ScottYates/ceilingclock/hardware/stl/lens_cap.stl

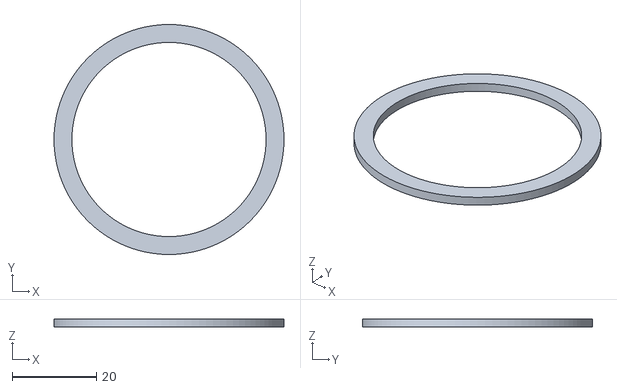
[picture p1: CAD file, 2026-10-31]
hardware/stl/lens_cap.stl
54.5 x 54.5 x 2.00
