ScottYates/ceilingclock/hardware/stl/lens_mount.stl

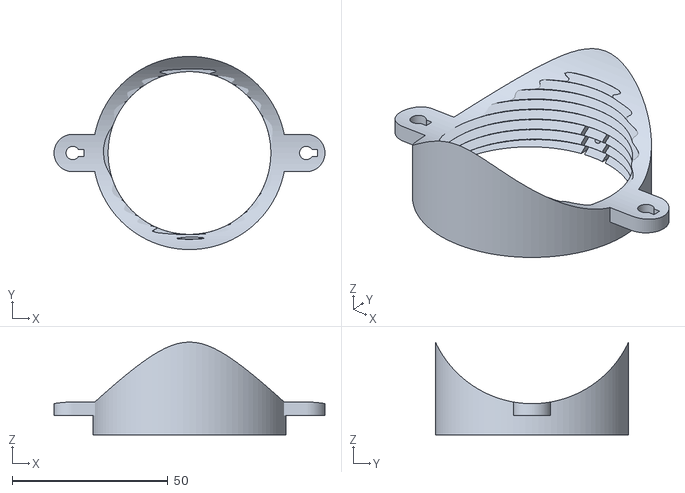
[picture p2: CAD file, 2026-10-31]
hardware/stl/lens_mount.stl
87.0 x 62.0 x 29.8
