ScottYates/ceilingclock/hardware/stl/base_056.stl

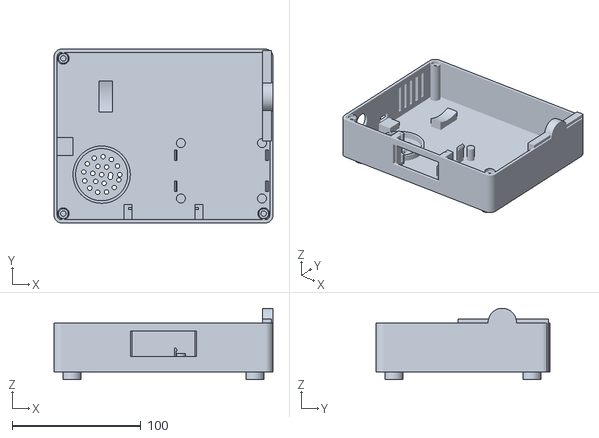
[picture p3: CAD file, 2026-10-31]
hardware/stl/base_056.stl
170.0 x 135.0 x 55.5
