ScottYates/ceilingclock/hardware/stl/lid.stl

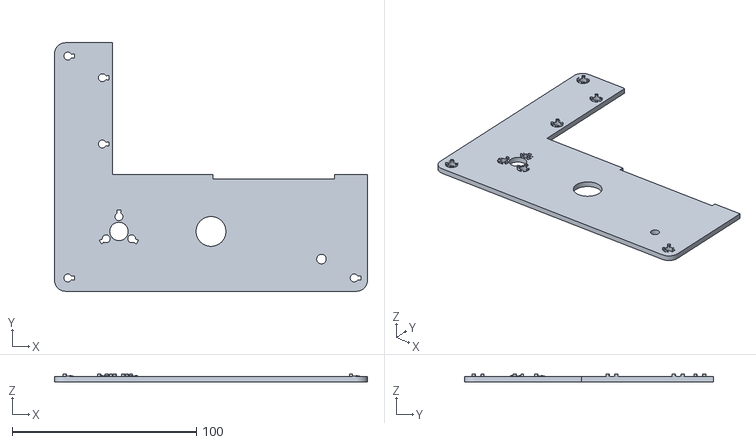
[picture p4: CAD file, 2026-10-31]
hardware/stl/lid.stl
170.0 x 135.0 x 4.20
