ScottYates/ceilingclock/hardware/stl/dome.stl

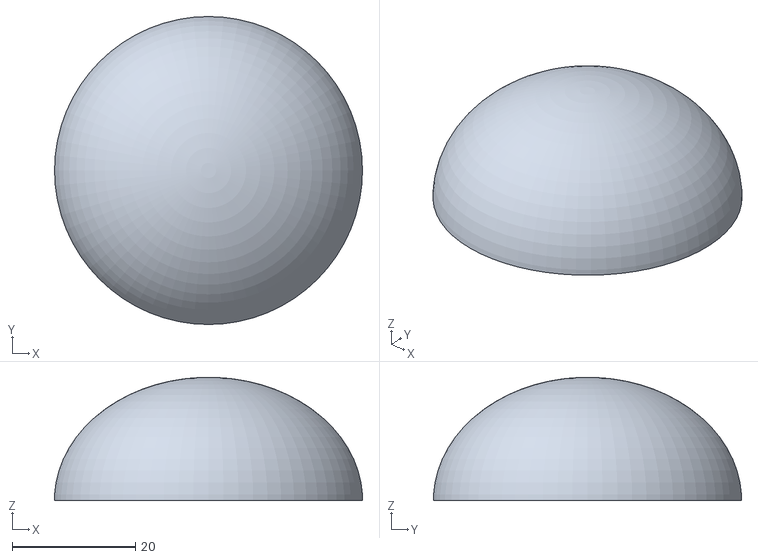
[picture p5: CAD file, 2026-10-31]
hardware/stl/dome.stl
49.9 x 49.9 x 20.0
