ScottYates/ceilingclock/hardware/stl/led_cap.stl

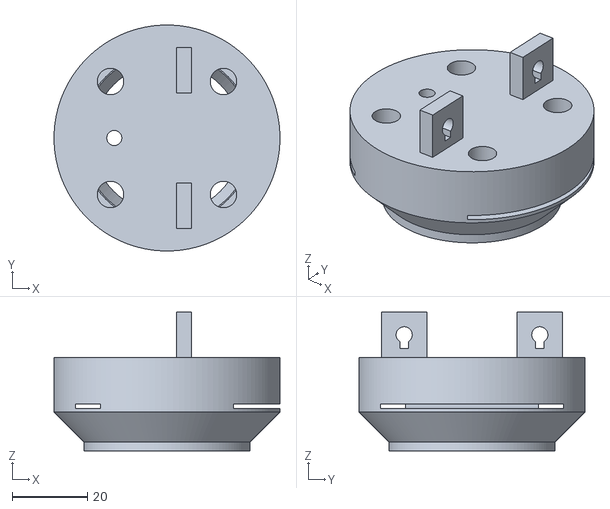
[picture p6: CAD file, 2026-10-31]
hardware/stl/led_cap.stl
60.0 x 60.0 x 36.8
