ScottYates/ceilingclock/hardware/stl/lcd_holder.stl

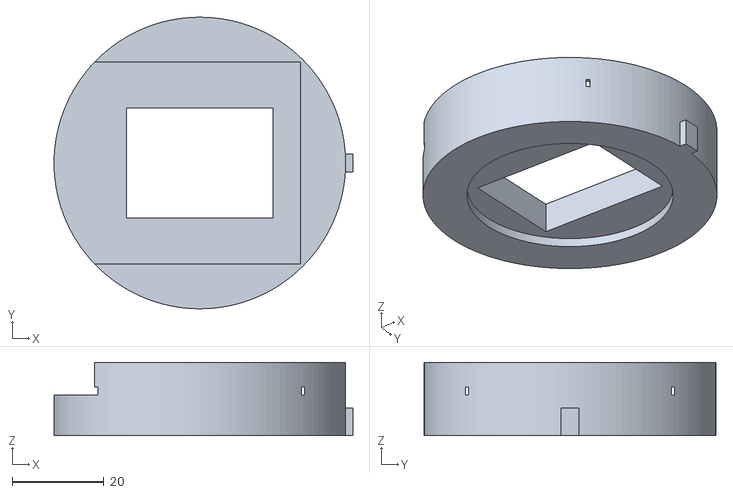
[picture p7: CAD file, 2026-10-31]
hardware/stl/lcd_holder.stl
65.2 x 63.6 x 16.0
