ScottYates/ceilingclock/hardware/stl/sleeve.stl

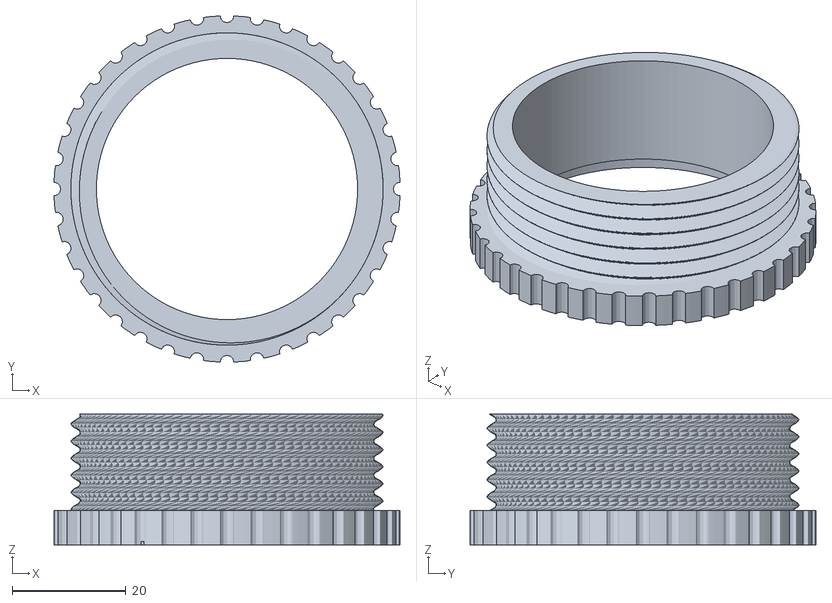
[picture p8: CAD file, 2026-10-31]
hardware/stl/sleeve.stl
60.9 x 60.9 x 23.0
