ScottYates/ceilingclock/hardware/stl/ring_holder.stl

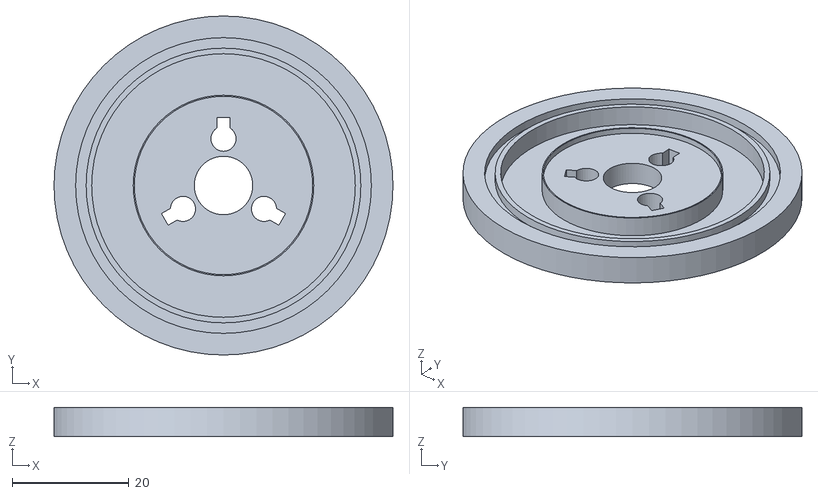
[picture p9: CAD file, 2026-10-31]
hardware/stl/ring_holder.stl
58.0 x 58.0 x 5.00
