ScottYates/ceilingclock/hardware/stl/barrel.stl

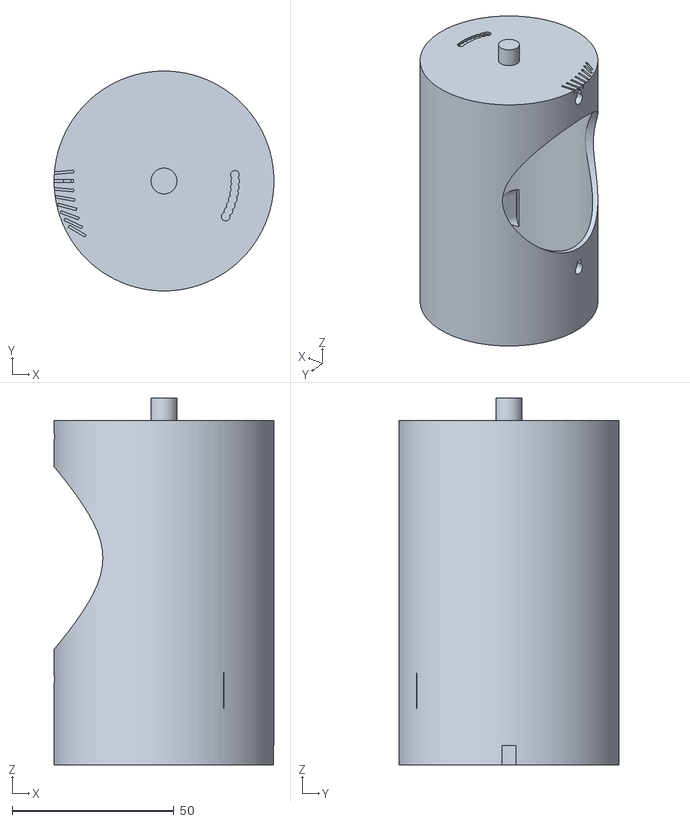
[picture p10: CAD file, 2026-10-31]
hardware/stl/barrel.stl
68.0 x 68.0 x 113.5
