ScottYates/ceilingclock/hardware/stl/pins.stl

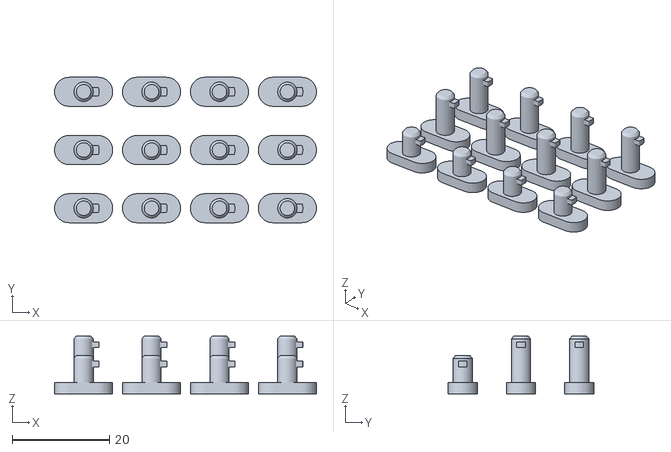
[picture p11: CAD file, 2026-10-31]
hardware/stl/pins.stl
54.0 x 30.0 x 11.9
