ScottYates/ceilingclock/(list of files, cad)

Other CAD files:
hardware/stl/base.stl
