ScottYates/ceilingclock/docs/img/step-1.png

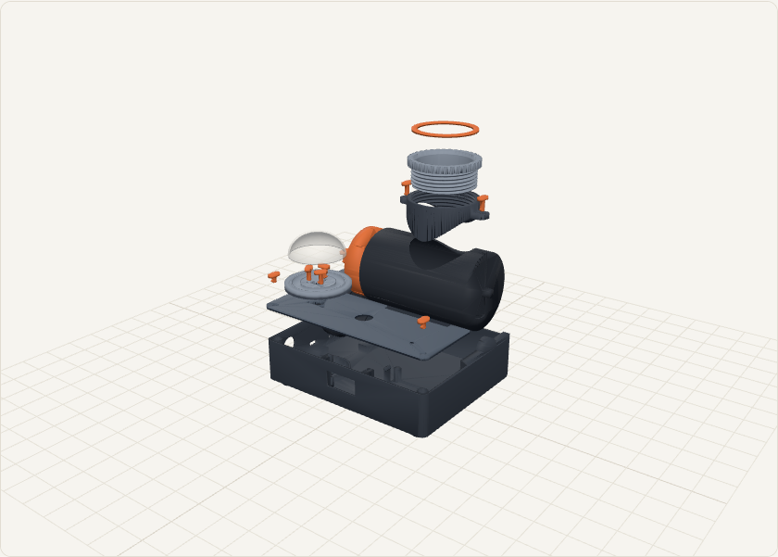
docs/img/step-1.png
