ScottYates/ceilingclock/docs/img/step-2.png

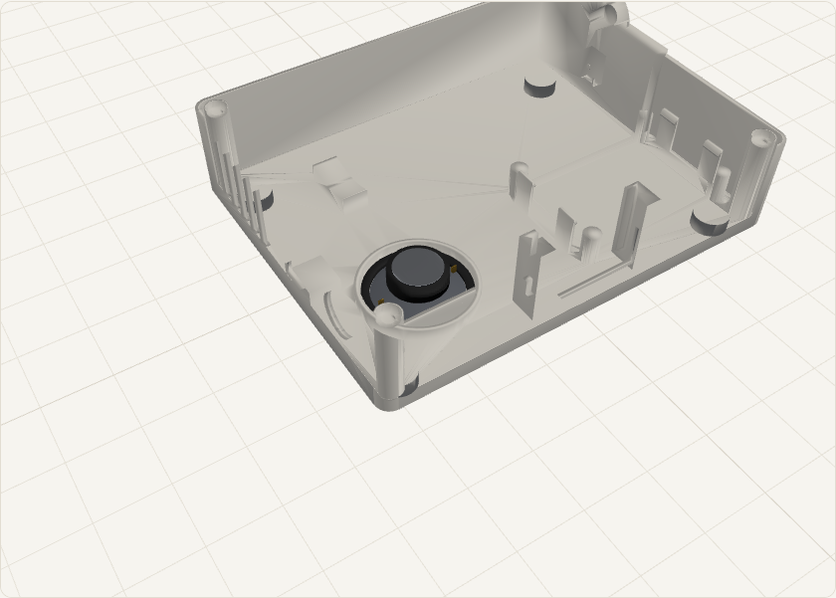
docs/img/step-2.png
