ScottYates/ceilingclock/docs/img/step-3.png

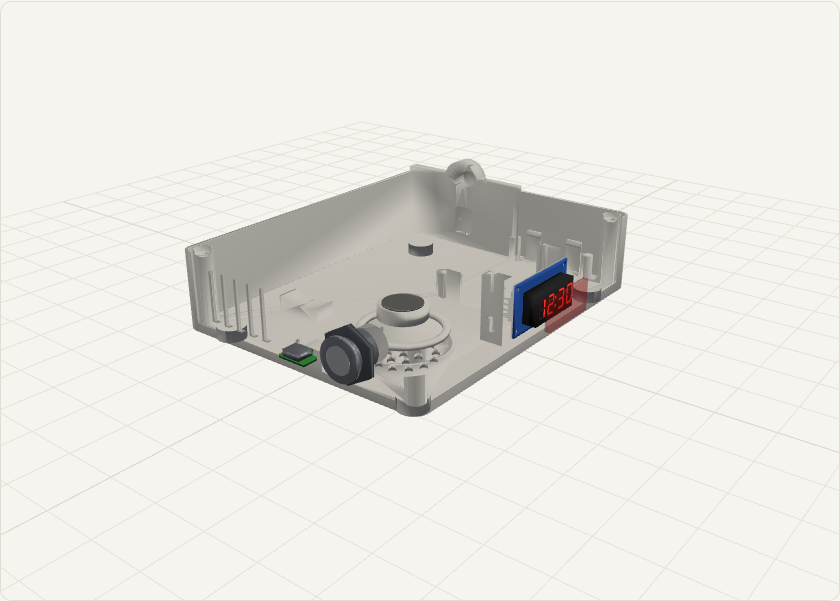
docs/img/step-3.png
