ScottYates/ceilingclock/docs/img/step-4.png

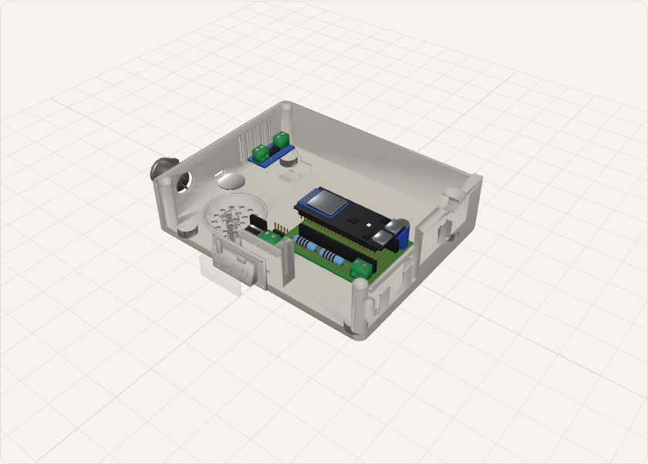
docs/img/step-4.png
