ScottYates/ceilingclock/docs/img/step-5.png

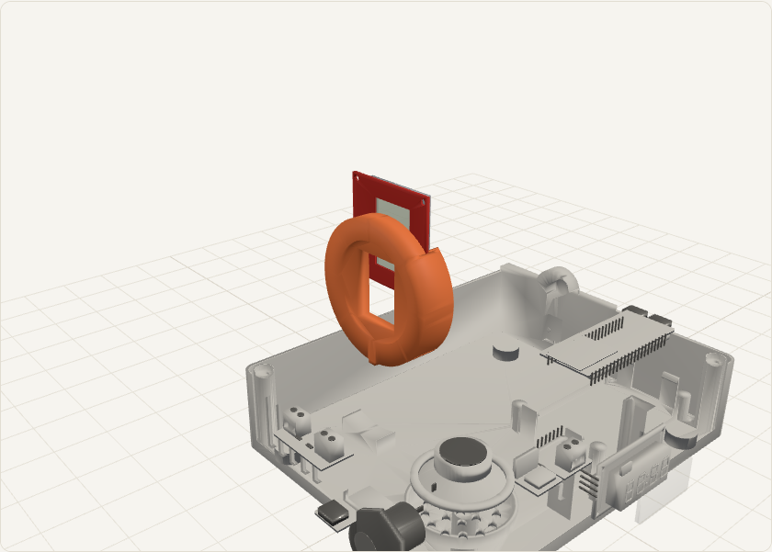
docs/img/step-5.png
