ScottYates/ceilingclock/docs/img/step-6.png

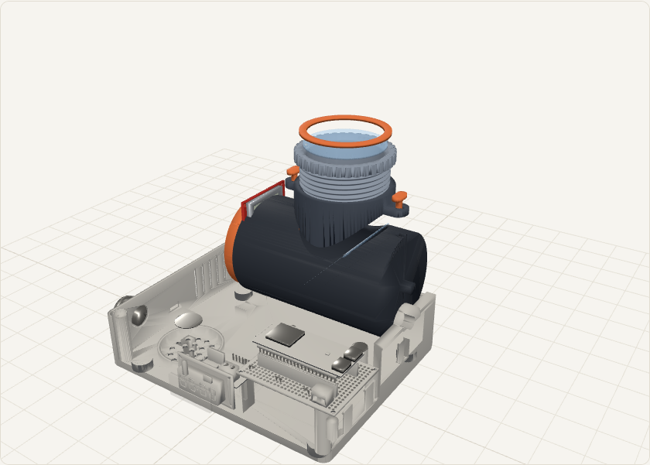
docs/img/step-6.png
