ScottYates/ceilingclock/docs/img/step-7.png

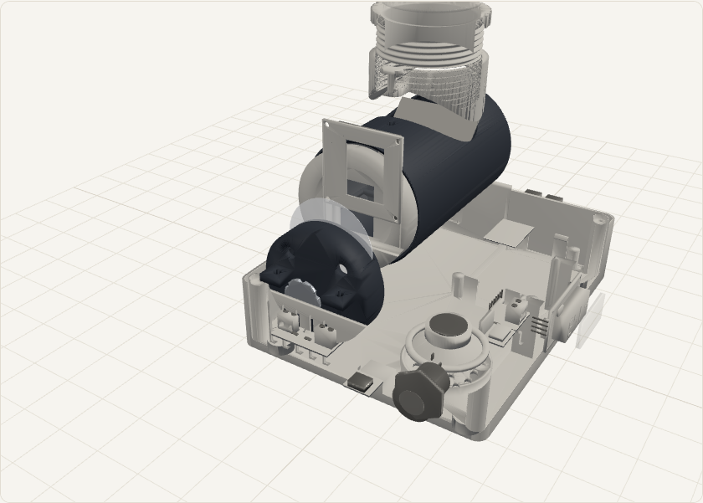
docs/img/step-7.png
