ScottYates/ceilingclock/docs/img/step-8.png

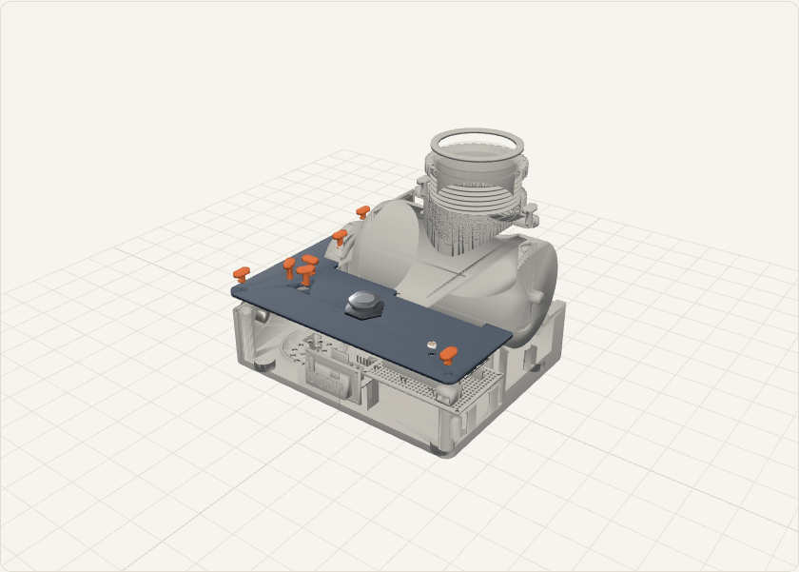
docs/img/step-8.png
