ScottYates/ceilingclock/docs/img/step-9.png

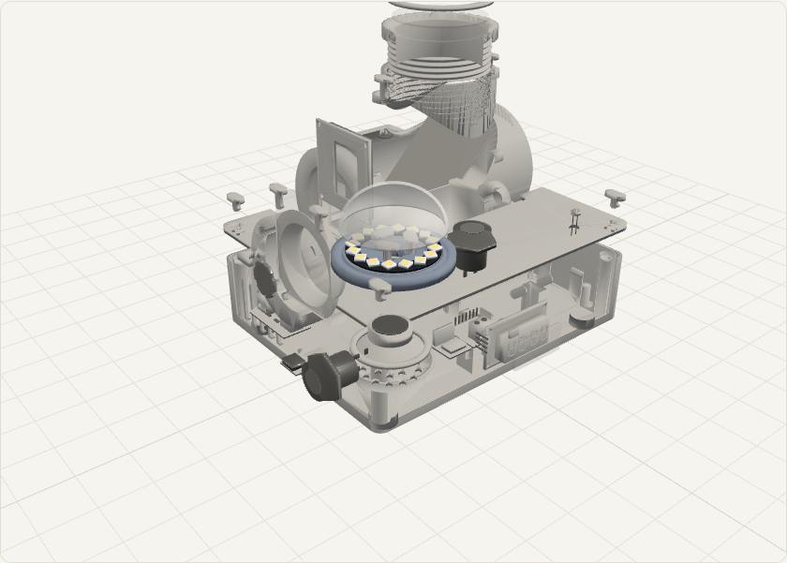
docs/img/step-9.png
