ScottYates/ceilingclock/docs/img/step-10.png

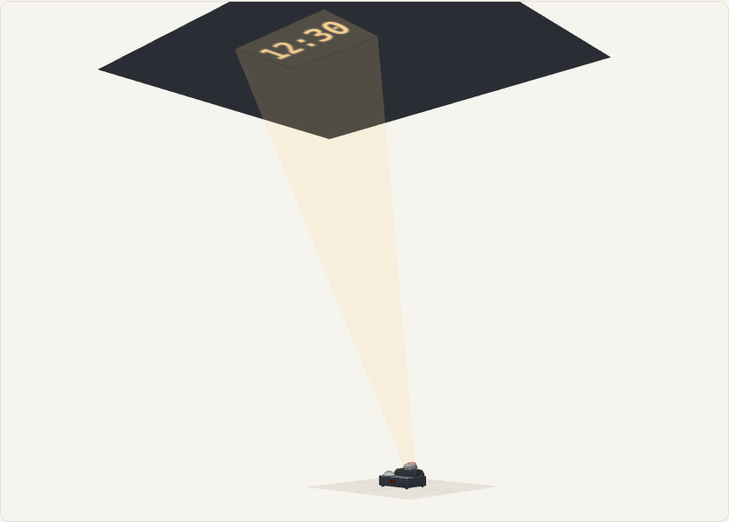
docs/img/step-10.png
