ScottYates/ceilingclock/(commit log)

2026-10-30 Add ESP32-S3 firmware for the ceiling projection alarm clock
    [partitions.csv]
2026-10-30 Add enclosure model, STLs and project site with 3D viewer, assembly steps, wiring and parts list
    [base.stl, carrier.stl, dome.stl, enclosure.scad, lens_cap.stl, lid.stl, ring_holder.stl, sleeve.stl]
2026-10-30 Parts list: replace two unreliable listings, add per-item Add to cart buttons
2026-10-30 Parts list: replace unavailable resistor and display listings
2026-10-30 Parts list: Amazon search for display and resistor, search links on every row; widen front window for 0.56-inch displays
    [base.stl, enclosure.scad]
2026-10-30 Use 0.36-inch TM1637 display (botzi B0FYG2FN2M); make display size a model parameter and add base_056.stl
    [base.stl, base_056.stl, enclosure.scad]
2026-10-30 Use Ceksezx dual MOSFET module (B0FMJH3DML); run LED PWM at 10 kHz to stay inside its rating
2026-10-30 Use BOJACK 1/4 W kit (B08FD1XVL6): 330 R, 10 k, and four 22 R in parallel for the LED
2026-10-30 Use BOJACK 2 W resistor kit (B09MS545M3): single 4.7 R 2 W LED resistor, 330 R and 10 k from the same kit
2026-10-30 Use Chironal GL5528 LDR (B07G48B3VL); list the M3 screws the build needs
2026-10-30 Use steel M3 screw kit for the case; nylon standoff kit optional
2026-10-30 Screwless case: printed snap pins for lid, tower and ring holder, snap hooks for the circuit board, tapered focus pin
    [base.stl, base_056.stl, carrier.stl, dome.stl, enclosure.scad, lens_cap.stl, lid.stl, pins.stl]
2026-10-30 Build fixes for ESP32-S3, live view of the clock on the web page, PC simulator, prebuilt firmware images and demo video
2026-10-30 3D model: realistic bought components (displays, buttons, boards, modules, LCD, LED, wiring) with per-material colours
    [components.scad, enclosure.scad]
2026-10-30 Fold the projector with a 45° mirror: the clock is 9 cm tall instead of 23 cm
    The LED, diffuser and LCD sit in a light box along the back of a 170 x 120 mm base and
    shine sideways onto a 50 x 50 mm front-surface mirror, which turns the light up through
    the same 100 mm lens in a short sleeve on the lid. The tower, carrier and old sleeve are
    replaced by lightbox, carriage, lens_mount and a 9 mm sleeve. Focus still slides the sleeve.
    Layout changes to fit: USB-C and button B move to the left side wall, the board moves to
    the front right with its hooks on the short edges, and the light sensor moves to the
    front-right corner of the lid, clear of the corner pin it used to sit on.
    Collision fixe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
    [base.stl, base_056.stl, carriage.stl, carrier.stl, components.scad, dome.stl, enclosure.scad, lens_cap.stl]
2026-10-30 3D view: open slightly less exploded so the lens and dome stay in frame
2026-10-30 Tilting projector: the LCD, mirror and lens ride in a barrel that rolls 0-30 degrees forward
    The barrel lies along the back of the clock with its axis on the light path, half sunk
    into the base. Rolling it tilts the beam forward (up to about 1 m at an 8 ft ceiling)
    without rotating the picture, because the LCD turns with the mirror and lens. The LED
    and diffuser sit in a fixed cap whose collar the barrel turns on; the right end has an
    axle in a bearing block with a sprung detent every 5 degrees from -5 to 30.
    The LCD now stands with its long side vertical, so the time reads left to right on the
    ceiling (the previous fold had it reading front to back).
    Base is 170 x 135 x 44 mm; the lid cov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
    [barrel.stl, base.stl, base_056.stl, carriage.stl, components.scad, dome.stl, enclosure.scad, lcd_holder.stl]
2026-10-30 Stream and podcast alarms, focus in the 3D view, and both in the live demo
    Alarms: each alarm can have a URL (internet radio, an MP3 link, or a podcast feed, which
    plays its newest episode). The alarm's sound file is the backup: if the stream hasn't
    started in 25 s, the feed can't be read or has no episodes, or the stream drops, the
    backup rings. A stream that played for a minute and dropped is reconnected up to twice.
    Feed parsing (feed_scan.h) reads RSS and Atom while downloading, with unit tests. The
    web page has the URL field, Preview stream, and shows the episode or station and why a
    stream failed.
    Simulator: streams, feed lookup (curl on a PC, the page in the browser build), and
    /sim/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
    [feed_scan.h, main.cpp, make_demo_page.py, net_fetch.h, net_fetch_esp.cpp, settings.cpp]
2026-10-30 Flip projection: turn the ceiling picture upside down from the web page or the 3D view
    New setting projUpsideDown turns the projected picture 180 degrees (both flips on top
    of the mirror settings). The clock's main card has a Flip projection button, the
    projector settings have an Upside down checkbox, and the Right now picture turns with
    it. The old Flip upside down checkbox only mirrored top to bottom, so it is now labelled
    Mirror top/bottom.
    The 3D model page has a Flip upside down button that shows the light on the ceiling and
    turns the time over. Prebuilt firmware images rebuilt.
    [main.cpp, settings.cpp, settings.h]
2026-10-30 Threaded focus ring: turn the knurled grip on top of the lens to focus
    The sliding sleeve sat below the mount's rim, so it couldn't be reached once assembled.
    The lens now sits in a sleeve with a coarse 3 mm-pitch thread that screws into a
    threaded collar (the lens mount) pinned to the barrel. A knurled grip with direction
    arrows stands clear of the collar at every focus position; one turn moves the lens 3 mm
    and the +/-5 mm range is about 1.5 turns each way. The thread holds its position, and a
    slotted springy tongue in the collar stops it creeping, so the focus pin is gone.
    To keep two turns of thread engaged, the lens sits 7 mm higher above the barrel axis and
    the LCD 7 mm nearer the mir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
    [barrel.stl, base.stl, base_056.stl, dome.stl, enclosure.scad, lcd_holder.stl, led_cap.stl, lens_cap.stl]
2026-10-31 Quarter-turn lock pins, as on the VoiceLabels case, replace the snap pins
    Push the pin in with its wing head along the slot, turn it a quarter turn: a lug rides
    up a 0.4 mm ramp on the inside face (pulling the head tight), clicks into a 0.15 mm
    notch, and a 1.2 mm stop keeps it from turning further. Dimensions follow VoiceLabels'
    case.py (4 mm shaft, 4.3 mm hole, 3.2 mm lug, 2.3 mm slot, 3.8 mm pocket); the wing head
    is 12 mm instead of 14 so it can turn beside the lens collar.
    Two lengths: short pins (3) lock the lid corners in pockets in the base posts; long pins
    (7) go through the LED cap tabs, the ring holder and the lens collar's tabs. The lid's
    ramps are on its underside, so the lid n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
    [barrel.stl, base.stl, base_056.stl, dome.stl, enclosure.scad, lcd_holder.stl, led_cap.stl, lens_cap.stl]
2026-10-31 Breadboard test guide
    New page docs/breadboard.html: what you need (two breadboards, since the DevKitC-1 is too
    wide for one), how to power things on the bench (ESP32 from the computer's USB for the
    log; the 5 V supply feeds only the amplifier, ring and LED; GND rails joined; external
    5 V kept off the ESP32's 5V pin), then ten steps adding one module at a time with a test
    for each, a bench test of the optics, and troubleshooting.
    docs/img/breadboard.svg is generated from pins.h by hardware/make_breadboard_svg.py.
    The page is in the site menu and linked from the assembly page and step 4.
2026-10-31 Breadboard test guide: illustrated, step by step, for beginners
    docs/breadboard.html is now generated by hardware/make_breadboard_guide.py from pins.h
    and the DevKitC-1 header order (Espressif's J1/J3 tables), so every wire in the pictures
    goes to the right physical pin.
    - Before you start: how a breadboard's holes connect, the three kinds of jumper wire,
    the colour code, and the golden rules (unplug while wiring, never feed the ESP32's
    5V pin from the adapter, keep the grounds joined).
    - The ESP32 sits beside the breadboard and connects with female jumpers: it's too wide
    to leave free holes on a standard breadboard. The breadboard carries the rails, the
    buttons, the light sensor an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
    [make_breadboard_guide.py]
2026-10-31 Breadboard guide: switch between ESP32 plugged into two breadboards and beside one
    Each step now has a picture, wire list and parts count for both layouts.
    Jumper types are worked out from the wire ends, and a check stops two
    wires landing in the same hole. Ticks are kept separately per layout and
    the chosen layout is remembered.
2026-11-05 Breadboard guide: real column order, and the ESP32 across both middle rail strips
    Breadboards with row 1 on the left have j at the top; the pictures had a
    at the top. In the plugged-in layout the ESP32 now goes in column j of
    the lower board and column a of the upper board with all rail strips
    left on, which matches the 1 inch pin spacing measured on a real pair of
    830-hole boards.
2026-11-05 Breadboard guide: add a one-breadboard layout
    The ESP32 plugs into the left end of a single 830-hole board (3V3 row in
    column b, GND/TX/RX row in column j, from row 5). Each wire to a pin goes
    into column a beside it; every part sits in rows 33-59. Pins 1 and 2 have
    no free hole on one board, so the DS3231 step says to test it later.
2026-11-05 Breadboard guide, one board: ESP32 from row 1, buttons further from the USB ports
    The ESP32 now starts at row 1 with its antenna over the end of the board
    (pins in rows 1-22). Buttons move to rows 33-35 and 39-41, about ten rows
    clear of the USB-C plugs; the light sensor and resistors shift along to
    rows 45-60.
2026-11-05 Breadboard guide: draw the ESP32's RST and BOOT buttons
2026-11-05 Breadboard guide: step-by-step check for missing 3.3 V on the rails
    The power step in each layout gets an ordered list: meter set-up, power
    LED, 3.3 V at the ESP32's own pins, at the 3V3 pin's free hole, at the +
    rail, split rails, the ground path, and swapped probes. Hole names follow
    the chosen layout.
    [make_breadboard_guide.py]
2026-11-05 Breadboard guide: what it means when the ESP32 resets while probing
    [make_breadboard_guide.py]
2026-11-05 Breadboard guide: correct the probe-reset note
    [make_breadboard_guide.py]
2026-11-05 Breadboard guide: put the meter lead check first
    The red lead in the A socket shorts the 3.3 V supply and resets the
    ESP32. The power step's test now says to check the lead and dial before
    measuring, and the 3.3 V check opens with it.
    [make_breadboard_guide.py]
2026-11-05 Front display confirms button presses
    A press of button B now shows 'd on' or 'd oF' for 1.5 s, and the 3 s
    hold shows 'P on' or 'P oF' the moment the projector switches, even when
    the front display is off. Prebuilt images and the browser demo rebuilt.
2026-11-05 Mount LittleFS by its partition label
    partitions.csv names the data partition 'littlefs', but LittleFS.begin()
    looks for 'spiffs' by default, so on the real board the file system never
    mounted: no beep.wav, no saved settings. Found on the first board
    (fsTotal 0). The simulator's LittleFS now fails to mount with the wrong
    label too, so this can't slip through again.
    [main.cpp, sim_hw.cpp]
2026-11-05 Breadboard guide: light sensor reading stuck near 4095, both causes
    [make_breadboard_guide.py]
2026-11-05 Breadboard guide: make the light sensor's 10 kOhm resistor impossible to miss
    The light sensor step now says up front that it needs two parts, warns
    that the sensor alone reads near 4095 and that 10 ohm is not 10 kOhm,
    and shows a picture of each part with the resistor's colour bands.
    Every step with parts gets a 'Place the parts' list with exact holes,
    and the pictures draw the 10 kOhm resistor larger, banded and labelled.
2026-11-08 Breadboard guide: how to solder the amplifier's header and screw terminal
    The amplifier step now starts with a four-panel picture: the header held
    straight in the breadboard with the short ends soldered on top, the
    screw terminal on the chip side with its openings facing out, good and
    bad joints (thin, blob, bridge), and the speaker wires. Matching steps
    in the text, and the 'You need' list includes the iron.
    [make_breadboard_guide.py]
2026-11-08 Breadboard guide: fold the amplifier soldering section away by default
2026-11-08 Breadboard guide: power rails with holes in groups of five
    Real full-size breadboards have rail holes at rows 3-7, 9-13, 15-19 and so
    on, with no hole at rows 8, 14, 20, ... The pictures now draw the rails
    that way, any rail connection that fell in a gap moves to the next hole
    (the 100 uF capacitor's - leg is now row 21, not 20), a few clashing rail
    holes moved, and the basics picture explains the gaps.
2026-11-09 Add an illustrated page for testing the amplifier
    docs/amp-test.html (from hardware/make_amp_test_page.py) walks through
    three checks with a multimeter and oscilloscope, written around the
    FNIRSI 2C53T: power (VIN and SD), the LRC/BCLK/DIN signals with what
    each trace should look like, and the amp's output. It names each piece
    (BNC plug, x10 switch, hook tip, ground clip, meter leads), shows where
    each one goes, and warns against clipping the scope ground to a speaker
    screw. The breadboard guide's amplifier step links to it.
2026-11-09 Amplifier test page: match the FNIRSI 2C53T manual
    Checked against the 2C53T manual and box contents: the probes are P6100
    x1/x10 (one or two per bundle), the meter sockets are COM, 10A, mA and
    volts/ohms, holding the home key selects the mode, AUTO shows the
    waveform, the probe and channel settings must match, and both ground
    clips must go to the same point. Adds a box-contents section and a note
    that the meter's automatic mode doesn't read below about 0.7 V, so SD
    may need DC volts selected by hand.
    [make_amp_test_page.py]
2026-11-09 Amplifier test page: drawing of the 2C53T front panel
    Drawn from a photo of Scott's meter: the red lead goes in VΩ and the
    black in COM (never 10A or mA), the probe goes in the top BNC marked
    CH1, and the AUTO, CH1 and MENU buttons are marked.
2026-11-09 Amplifier test page: keep probe and ground leads clear of the labels
    In the signal check the probe now leaves the DIN joint downward and the
    ground lead runs under the board to the clip; in the output check the
    probe leaves the + screw up to the left and the ground lead loops round
    the board. No lead crosses any text.
2026-11-09 Amplifier test page: meter drawings without crossing lines
    On the 2C53T panel both test leads now leave to the right without
    crossing each other or the socket labels, and the CH1, AUTO and MENU
    callouts run straight to the edge of each button. In the power check
    the two probes splay apart instead of crossing.
2026-11-09 Amplifier test page: keep the power check's captions off the boards
